berlinwu0425/rv32imzicsr-processor/formal/equiv_full_results.csv

name | result | expected
equiv_D0_F0_L0 | PASS | PASS
equiv_D0_F0_L2 | PASS | PASS
equiv_D0_F0_L4 | PASS | PASS
equiv_D0_F1_L0 | PASS | PASS
equiv_D0_F1_L2 | PASS | PASS
equiv_D0_F1_L4 | PASS | PASS
equiv_D0_F2_L0 | FAIL | FAIL
equiv_D0_F2_L2 | PASS | PASS
equiv_D0_F2_L4 | PASS | PASS
equiv_D0_F3_L0 | FAIL | FAIL
equiv_D0_F3_L2 | PASS | PASS
equiv_D0_F3_L4 | PASS | PASS
equiv_D0_F4_L0 | FAIL | FAIL
equiv_D0_F4_L2 | FAIL | FAIL
equiv_D0_F4_L4 | PASS | PASS
equiv_D0_F5_L0 | FAIL | FAIL
equiv_D0_F5_L2 | FAIL | FAIL
equiv_D0_F5_L4 | PASS | PASS
equiv_D0_F6_L0 | FAIL | FAIL
equiv_D0_F6_L2 | FAIL | FAIL
equiv_D0_F6_L4 | FAIL | FAIL
equiv_D0_F7_L0 | FAIL | FAIL
equiv_D0_F7_L2 | FAIL | FAIL
equiv_D0_F7_L4 | FAIL | FAIL
equiv_D0_F8_L0 | FAIL | FAIL
equiv_D0_F8_L2 | FAIL | FAIL
equiv_D0_F8_L4 | FAIL | FAIL
equiv_D0_F9_L0 | FAIL | FAIL
equiv_D0_F9_L2 | FAIL | FAIL
equiv_D0_F9_L4 | FAIL | FAIL
equiv_D0_F10_L0 | FAIL | FAIL
equiv_D0_F10_L2 | FAIL | FAIL
equiv_D0_F10_L4 | FAIL | FAIL
equiv_D1_F0_L0 | PASS | PASS
equiv_D1_F0_L2 | PASS | PASS
equiv_D1_F0_L4 | PASS | PASS
equiv_D1_F1_L0 | PASS | PASS
equiv_D1_F1_L2 | PASS | PASS
equiv_D1_F1_L4 | PASS | PASS
equiv_D1_F2_L0 | PASS | PASS
equiv_D1_F2_L2 | PASS | PASS
equiv_D1_F2_L4 | PASS | PASS
equiv_D1_F3_L0 | FAIL | FAIL
equiv_D1_F3_L2 | PASS | PASS
equiv_D1_F3_L4 | PASS | PASS
equiv_D1_F4_L0 | FAIL | FAIL
equiv_D1_F4_L2 | PASS | PASS
equiv_D1_F4_L4 | PASS | PASS
equiv_D1_F5_L0 | FAIL | FAIL
equiv_D1_F5_L2 | FAIL | FAIL
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
equiv_D8_F11_L2 | PASS | PASS
equiv_D8_F12_L2 | FAIL | FAIL
equiv_D5_F11_L4 | FAIL | FAIL
equiv_D6_F11_L4 | PASS | PASS
equiv_D6_F12_L4 | FAIL | FAIL
equiv_D7_F12_L4 | PASS | PASS
equiv_D7_F13_L4 | FAIL | FAIL
equiv_D8_F13_L4 | PASS | PASS
equiv_D8_F14_L4 | FAIL | FAIL
