berlinwu0425/rv32imzicsr-processor/formal/extend_d2_results.csv

section | D | F | S | expected | actual | match
4.8 | D=2 | F=0 | S=0 | PASS | PASS | OK
4.8 | D=2 | F=1 | S=0 | PASS | PASS | OK
4.8 | D=2 | F=2 | S=0 | PASS | PASS | OK
4.8 | D=2 | F=5 | S=0 | FAIL | FAIL | OK
4.8 | D=2 | F=6 | S=0 | FAIL | FAIL | OK
4.8 | D=2 | F=7 | S=0 | FAIL | FAIL | OK
4.8 | D=2 | F=8 | S=0 | FAIL | FAIL | OK
4.8 | D=2 | F=9 | S=0 | FAIL | FAIL | OK
4.8 | D=2 | F=10 | S=0 | FAIL | FAIL | OK
4.8 | D=2 | F=0 | S=1 | PASS | PASS | OK
4.8 | D=2 | F=1 | S=1 | PASS | PASS | OK
4.8 | D=2 | F=2 | S=1 | PASS | PASS | OK
4.8 | D=2 | F=3 | S=1 | PASS | PASS | OK
4.8 | D=2 | F=6 | S=1 | FAIL | FAIL | OK
4.8 | D=2 | F=7 | S=1 | FAIL | FAIL | OK
4.8 | D=2 | F=8 | S=1 | FAIL | FAIL | OK
4.8 | D=2 | F=9 | S=1 | FAIL | FAIL | OK
4.8 | D=2 | F=10 | S=1 | FAIL | FAIL | OK
4.8 | D=2 | F=0 | S=2 | PASS | PASS | OK
4.8 | D=2 | F=1 | S=2 | PASS | PASS | OK
4.8 | D=2 | F=2 | S=2 | PASS | PASS | OK
4.8 | D=2 | F=3 | S=2 | PASS | PASS | OK
4.8 | D=2 | F=4 | S=2 | PASS | PASS | OK
4.8 | D=2 | F=7 | S=2 | FAIL | FAIL | OK
4.8 | D=2 | F=8 | S=2 | FAIL | FAIL | OK
4.8 | D=2 | F=9 | S=2 | FAIL | FAIL | OK
4.8 | D=2 | F=10 | S=2 | FAIL | FAIL | OK
4.8 | D=2 | F=0 | S=3 | PASS | PASS | OK
4.8 | D=2 | F=1 | S=3 | PASS | PASS | OK
4.8 | D=2 | F=2 | S=3 | PASS | PASS | OK
4.8 | D=2 | F=3 | S=3 | PASS | PASS | OK
4.8 | D=2 | F=4 | S=3 | PASS | PASS | OK
4.8 | D=2 | F=5 | S=3 | PASS | PASS | OK
4.8 | D=2 | F=8 | S=3 | FAIL | FAIL | OK
4.8 | D=2 | F=9 | S=3 | FAIL | FAIL | OK
4.8 | D=2 | F=10 | S=3 | FAIL | FAIL | OK
