berlinwu0425/rv32imzicsr-processor/formal/extend_final_gaps_results.csv

section | D | F | param | expected | actual | match
4.8 | D=0 | F=8 | S=0 | FAIL | FAIL | OK
4.8 | D=0 | F=9 | S=0 | FAIL | FAIL | OK
4.8 | D=0 | F=10 | S=0 | FAIL | FAIL | OK
4.8 | D=0 | F=8 | S=1 | FAIL | FAIL | OK
4.8 | D=0 | F=9 | S=1 | FAIL | FAIL | OK
4.8 | D=0 | F=10 | S=1 | FAIL | FAIL | OK
4.8 | D=0 | F=8 | S=2 | FAIL | FAIL | OK
4.8 | D=0 | F=9 | S=2 | FAIL | FAIL | OK
4.8 | D=0 | F=10 | S=2 | FAIL | FAIL | OK
4.8 | D=0 | F=8 | S=3 | FAIL | FAIL | OK
4.8 | D=0 | F=9 | S=3 | FAIL | FAIL | OK
4.8 | D=0 | F=10 | S=3 | FAIL | FAIL | OK
4.8 | D=1 | F=8 | S=0 | FAIL | FAIL | OK
4.8 | D=1 | F=9 | S=0 | FAIL | FAIL | OK
4.8 | D=1 | F=10 | S=0 | FAIL | FAIL | OK
4.8 | D=1 | F=8 | S=1 | FAIL | FAIL | OK
4.8 | D=1 | F=9 | S=1 | FAIL | FAIL | OK
4.8 | D=1 | F=10 | S=1 | FAIL | FAIL | OK
4.8 | D=1 | F=8 | S=2 | FAIL | FAIL | OK
4.8 | D=1 | F=9 | S=2 | FAIL | FAIL | OK
4.8 | D=1 | F=10 | S=2 | FAIL | FAIL | OK
4.8 | D=1 | F=8 | S=3 | FAIL | FAIL | OK
4.8 | D=1 | F=9 | S=3 | FAIL | FAIL | OK
4.8 | D=1 | F=10 | S=3 | FAIL | FAIL | OK
4.7 | D=6 | F=11 | L=4 | PASS | PASS | OK
4.7 | D=6 | F=12 | L=4 | FAIL | FAIL | OK
4.7 | D=7 | F=12 | L=4 | PASS | PASS | OK
4.7 | D=7 | F=13 | L=4 | FAIL | FAIL | OK
4.7 | D=8 | F=13 | L=4 | PASS | PASS | OK
4.7 | D=8 | F=14 | L=4 | FAIL | FAIL | OK
4.7 | D=8 | F=11 | L=2 | PASS | PASS | OK
4.7 | D=8 | F=12 | L=2 | FAIL | FAIL | OK
