berlinwu0425/rv32imzicsr-processor/formal/extend_results.csv

section | D | F | L_or_S | expected | actual | match
4.6 | D=0 | F=5 | - | FAIL | FAIL | OK
4.6 | D=0 | F=6 | - | FAIL | FAIL | OK
4.6 | D=0 | F=7 | - | FAIL | FAIL | OK
4.6 | D=0 | F=8 | - | FAIL | FAIL | OK
4.6 | D=0 | F=9 | - | FAIL | FAIL | OK
4.6 | D=0 | F=10 | - | FAIL | FAIL | OK
4.6 | D=1 | F=5 | - | FAIL | FAIL | OK
4.6 | D=1 | F=6 | - | FAIL | FAIL | OK
4.6 | D=1 | F=7 | - | FAIL | FAIL | OK
4.6 | D=1 | F=8 | - | FAIL | FAIL | OK
4.6 | D=1 | F=9 | - | FAIL | FAIL | OK
4.6 | D=1 | F=10 | - | FAIL | FAIL | OK
4.6 | D=2 | F=5 | - | FAIL | FAIL | OK
4.6 | D=2 | F=6 | - | FAIL | FAIL | OK
4.6 | D=2 | F=7 | - | FAIL | FAIL | OK
4.6 | D=2 | F=8 | - | FAIL | FAIL | OK
4.6 | D=2 | F=9 | - | FAIL | FAIL | OK
4.6 | D=2 | F=10 | - | FAIL | FAIL | OK
4.6 | D=3 | F=6 | - | FAIL | FAIL | OK
4.6 | D=3 | F=7 | - | FAIL | FAIL | OK
4.6 | D=3 | F=8 | - | FAIL | FAIL | OK
4.6 | D=3 | F=9 | - | FAIL | FAIL | OK
4.6 | D=3 | F=10 | - | FAIL | FAIL | OK
4.6 | D=4 | F=0 | - | PASS | PASS | OK
4.6 | D=4 | F=1 | - | PASS | PASS | OK
4.6 | D=4 | F=2 | - | PASS | PASS | OK
4.6 | D=4 | F=3 | - | PASS | PASS | OK
4.6 | D=4 | F=4 | - | PASS | PASS | OK
4.6 | D=4 | F=5 | - | PASS | PASS | OK
4.6 | D=4 | F=6 | - | FAIL | FAIL | OK
4.6 | D=4 | F=7 | - | FAIL | FAIL | OK
4.6 | D=4 | F=8 | - | FAIL | FAIL | OK
4.6 | D=4 | F=9 | - | FAIL | FAIL | OK
4.6 | D=4 | F=10 | - | FAIL | FAIL | OK
4.6 | D=5 | F=0 | - | PASS | PASS | OK
4.6 | D=5 | F=1 | - | PASS | PASS | OK
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
4.8 | D=8 | F=4 | S=3 | PASS | PASS | OK
4.8 | D=8 | F=5 | S=3 | PASS | PASS | OK
4.8 | D=8 | F=6 | S=3 | PASS | PASS | OK
4.8 | D=8 | F=7 | S=3 | PASS | PASS | OK
4.8 | D=8 | F=8 | S=3 | PASS | PASS | OK
4.8 | D=8 | F=9 | S=3 | PASS | PASS | OK
4.8 | D=8 | F=10 | S=3 | PASS | PASS | OK
