berlinwu0425/rv32imzicsr-processor/docs/ERRATA.md

# 勘誤表（Errata）

本表更正 [docs/report.pdf](report.pdf) 中已知的錯誤。報告 PDF 維持提交時的版本不再修改，以本表為準。

最後更新：2026-10-16

---

## 1. 第 4.8 節：掃描組數

**原文**：涵蓋 D ∈ {0, 1, …, 8}、F ∈ {0, 1, …, 10}、S ∈ {0, 1, 2, 3}，共 384 組獨立驗證。

**更正**：應為 **396 組**（9 × 11 × 4）。提交時缺少 D ∈ {0, 1}、F ∈ {6, 7}、S ∈ {0, 1, 2} 的 12 組，已於 2026-10-16 補跑，結果皆與邊界公式一致。三組邊界掃描合計 **792 組**（99 + 297 + 396）。

## 2. 圖八：安全區標註

**原文**：Safe（相對觀察一基準線，經 20 組獨立形式化驗證支持）

**更正**：應為 **99 組**（第 4.6 節，D 0–8 × F 0–10）。

## 3. 第 4.7 節：「safety 與 liveness 安全區完全重合」（補充說明）

在 `speculative_equivalence_model.v` 中，kill 訊號只在誤判時發出，正確路徑的指令不會被 kill，因此 liveness 在此模型中結構上必然成立，兩者安全區重合是模型設計的直接結果。報告中「kill/commit 只要維持正確性就不會犧牲進度」的推論在本模型設定下成立，但不宜推廣為一般性結論。
