berlinwu0425/rv32imzicsr-processor/fpga/ego1.xdc

## =========================================================================
## EGO1 板子 (XC7A35T-1CSG324C) 約束檔
## 接腳資料來源：E-elements 官方使用手冊 (e-elements.readthedocs.io)
## =========================================================================

## ---- 系統時脈 (官方確認: 100MHz) ----
set_property -dict {PACKAGE_PIN P17 IOSTANDARD LVCMOS33} [get_ports sysclk]
create_clock -period 10.000 -name sysclk -waveform {0.000 5.000} [get_ports sysclk]

## ---- Reset 按鈕 (官方專用按鈕 RST/S6) ----
set_property -dict {PACKAGE_PIN P15 IOSTANDARD LVCMOS33} [get_ports btn_reset]

## ---- LED D2群組 (8顆)：CPU軟體自己控制的階段標記 ----
set_property -dict {PACKAGE_PIN K2 IOSTANDARD LVCMOS33} [get_ports {led[0]}]
set_property -dict {PACKAGE_PIN J2 IOSTANDARD LVCMOS33} [get_ports {led[1]}]
set_property -dict {PACKAGE_PIN J3 IOSTANDARD LVCMOS33} [get_ports {led[2]}]
set_property -dict {PACKAGE_PIN H4 IOSTANDARD LVCMOS33} [get_ports {led[3]}]
set_property -dict {PACKAGE_PIN J4 IOSTANDARD LVCMOS33} [get_ports {led[4]}]
set_property -dict {PACKAGE_PIN G3 IOSTANDARD LVCMOS33} [get_ports {led[5]}]
set_property -dict {PACKAGE_PIN G4 IOSTANDARD LVCMOS33} [get_ports {led[6]}]
set_property -dict {PACKAGE_PIN F6 IOSTANDARD LVCMOS33} [get_ports {led[7]}]

## ---- LED D1群組 (8顆)：獨立硬體檢查器的PASS結果 (bit0~3=每項測試, bit4=全部通過總燈號) ----
set_property -dict {PACKAGE_PIN K3 IOSTANDARD LVCMOS33} [get_ports {pass_led[0]}]
set_property -dict {PACKAGE_PIN M1 IOSTANDARD LVCMOS33} [get_ports {pass_led[1]}]
set_property -dict {PACKAGE_PIN L1 IOSTANDARD LVCMOS33} [get_ports {pass_led[2]}]
set_property -dict {PACKAGE_PIN K6 IOSTANDARD LVCMOS33} [get_ports {pass_led[3]}]
set_property -dict {PACKAGE_PIN J5 IOSTANDARD LVCMOS33} [get_ports {pass_led[4]}]
set_property -dict {PACKAGE_PIN H5 IOSTANDARD LVCMOS33} [get_ports {pass_led[5]}]
set_property -dict {PACKAGE_PIN H6 IOSTANDARD LVCMOS33} [get_ports {pass_led[6]}]
set_property -dict {PACKAGE_PIN K1 IOSTANDARD LVCMOS33} [get_ports {pass_led[7]}]

## ---- 7段顯示器：段選訊號 ----
set_property -dict {PACKAGE_PIN B4 IOSTANDARD LVCMOS33} [get_ports {seg0[0]}]
set_property -dict {PACKAGE_PIN A4 IOSTANDARD LVCMOS33} [get_ports {seg0[1]}]
set_property -dict {PACKAGE_PIN A3 IOSTANDARD LVCMOS33} [get_ports {seg0[2]}]
set_property -dict {PACKAGE_PIN B1 IOSTANDARD LVCMOS33} [get_ports {seg0[3]}]
set_property -dict {PACKAGE_PIN A1 IOSTANDARD LVCMOS33} [get_ports {seg0[4]}]
set_property -dict {PACKAGE_PIN B3 IOSTANDARD LVCMOS33} [get_ports {seg0[5]}]
set_property -dict {PACKAGE_PIN B2 IOSTANDARD LVCMOS33} [get_ports {seg0[6]}]
set_property -dict {PACKAGE_PIN D5 IOSTANDARD LVCMOS33} [get_ports {seg0[7]}]

set_property -dict {PACKAGE_PIN D4 IOSTANDARD LVCMOS33} [get_ports {seg1[0]}]
set_property -dict {PACKAGE_PIN E3 IOSTANDARD LVCMOS33} [get_ports {seg1[1]}]
set_property -dict {PACKAGE_PIN D3 IOSTANDARD LVCMOS33} [get_ports {seg1[2]}]
set_property -dict {PACKAGE_PIN F4 IOSTANDARD LVCMOS33} [get_ports {seg1[3]}]
set_property -dict {PACKAGE_PIN F3 IOSTANDARD LVCMOS33} [get_ports {seg1[4]}]
set_property -dict {PACKAGE_PIN E2 IOSTANDARD LVCMOS33} [get_ports {seg1[5]}]
set_property -dict {PACKAGE_PIN D2 IOSTANDARD LVCMOS33} [get_ports {seg1[6]}]
set_property -dict {PACKAGE_PIN H2 IOSTANDARD LVCMOS33} [get_ports {seg1[7]}]

## ---- 7段顯示器：位選訊號 ----
set_property -dict {PACKAGE_PIN G2 IOSTANDARD LVCMOS33} [get_ports {digit_sel[0]}]
set_property -dict {PACKAGE_PIN C2 IOSTANDARD LVCMOS33} [get_ports {digit_sel[1]}]
set_property -dict {PACKAGE_PIN C1 IOSTANDARD LVCMOS33} [get_ports {digit_sel[2]}]
set_property -dict {PACKAGE_PIN H1 IOSTANDARD LVCMOS33} [get_ports {digit_sel[3]}]
set_property -dict {PACKAGE_PIN G1 IOSTANDARD LVCMOS33} [get_ports {digit_sel[4]}]
set_property -dict {PACKAGE_PIN F1 IOSTANDARD LVCMOS33} [get_ports {digit_sel[5]}]
set_property -dict {PACKAGE_PIN E1 IOSTANDARD LVCMOS33} [get_ports {digit_sel[6]}]
set_property -dict {PACKAGE_PIN G6 IOSTANDARD LVCMOS33} [get_ports {digit_sel[7]}]

## ---- CPU 核心衍生時脈宣告：cpu_clk 是 sysclk 除以32產生的 ----
## 這樣時序分析才會正確涵蓋到 CPU 核心內部的關鍵路徑，
## 不會被誤判成 Unconstrained Paths
create_generated_clock -name cpu_clk -source [get_ports sysclk] -divide_by 32 [get_pins cpu_clk_reg/Q]

## ---- UART 外部觸發介面 (接到板子上的 USB-UART/JTAG 接口) ----
set_property -dict {PACKAGE_PIN N5 IOSTANDARD LVCMOS33} [get_ports uart_rx_pin]
set_property -dict {PACKAGE_PIN T4 IOSTANDARD LVCMOS33} [get_ports uart_tx_pin]


## ---- S0 按鍵 (預設低電位，按下時輸出高電位) ----
set_property -dict {PACKAGE_PIN R11 IOSTANDARD LVCMOS33} [get_ports btn_s0]

## ---- SW0~SW7 撥動開關 ----
set_property -dict {PACKAGE_PIN R1 IOSTANDARD LVCMOS33} [get_ports {switches[0]}]
set_property -dict {PACKAGE_PIN N4 IOSTANDARD LVCMOS33} [get_ports {switches[1]}]
set_property -dict {PACKAGE_PIN M4 IOSTANDARD LVCMOS33} [get_ports {switches[2]}]
set_property -dict {PACKAGE_PIN R2 IOSTANDARD LVCMOS33} [get_ports {switches[3]}]
set_property -dict {PACKAGE_PIN P2 IOSTANDARD LVCMOS33} [get_ports {switches[4]}]
set_property -dict {PACKAGE_PIN P3 IOSTANDARD LVCMOS33} [get_ports {switches[5]}]
set_property -dict {PACKAGE_PIN P4 IOSTANDARD LVCMOS33} [get_ports {switches[6]}]
set_property -dict {PACKAGE_PIN P5 IOSTANDARD LVCMOS33} [get_ports {switches[7]}]
