berlinwu0425/rv32imzicsr-processor/(commit log)

2026-10-15 RV32IMZicsr processor with multi-layer verification and formal safety-boundary analysis
    [extend_d2_results.csv, extend_final_gaps_results.csv, extend_results.csv]
2026-10-16 Supplementary formal verification and errata
    [equiv_full_results.csv]
